keycube/k3pcb/matrice-pcb-keycube/image/Add-symbol-socket.png

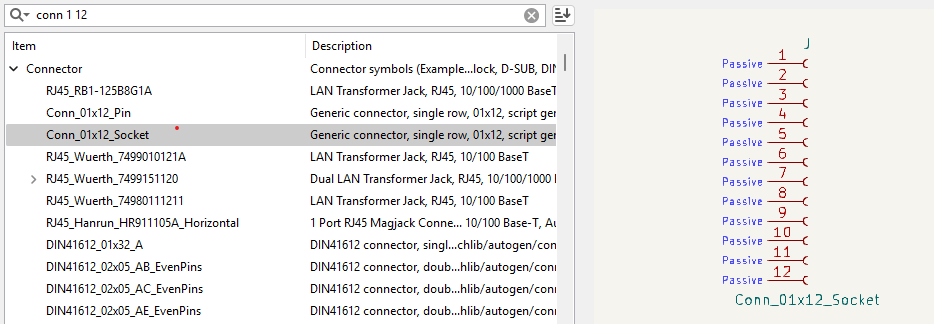
matrice-pcb-keycube/image/Add-symbol-socket.png
