keycube/k3pcb/shield-pcb-keycube/shield-keycube-v1/shield-keycube-v1.kicad_pcb

## KiCad design shield-pcb-keycube/shield-keycube-v1/shield-keycube-v1.kicad_pcb (2025-05-05)

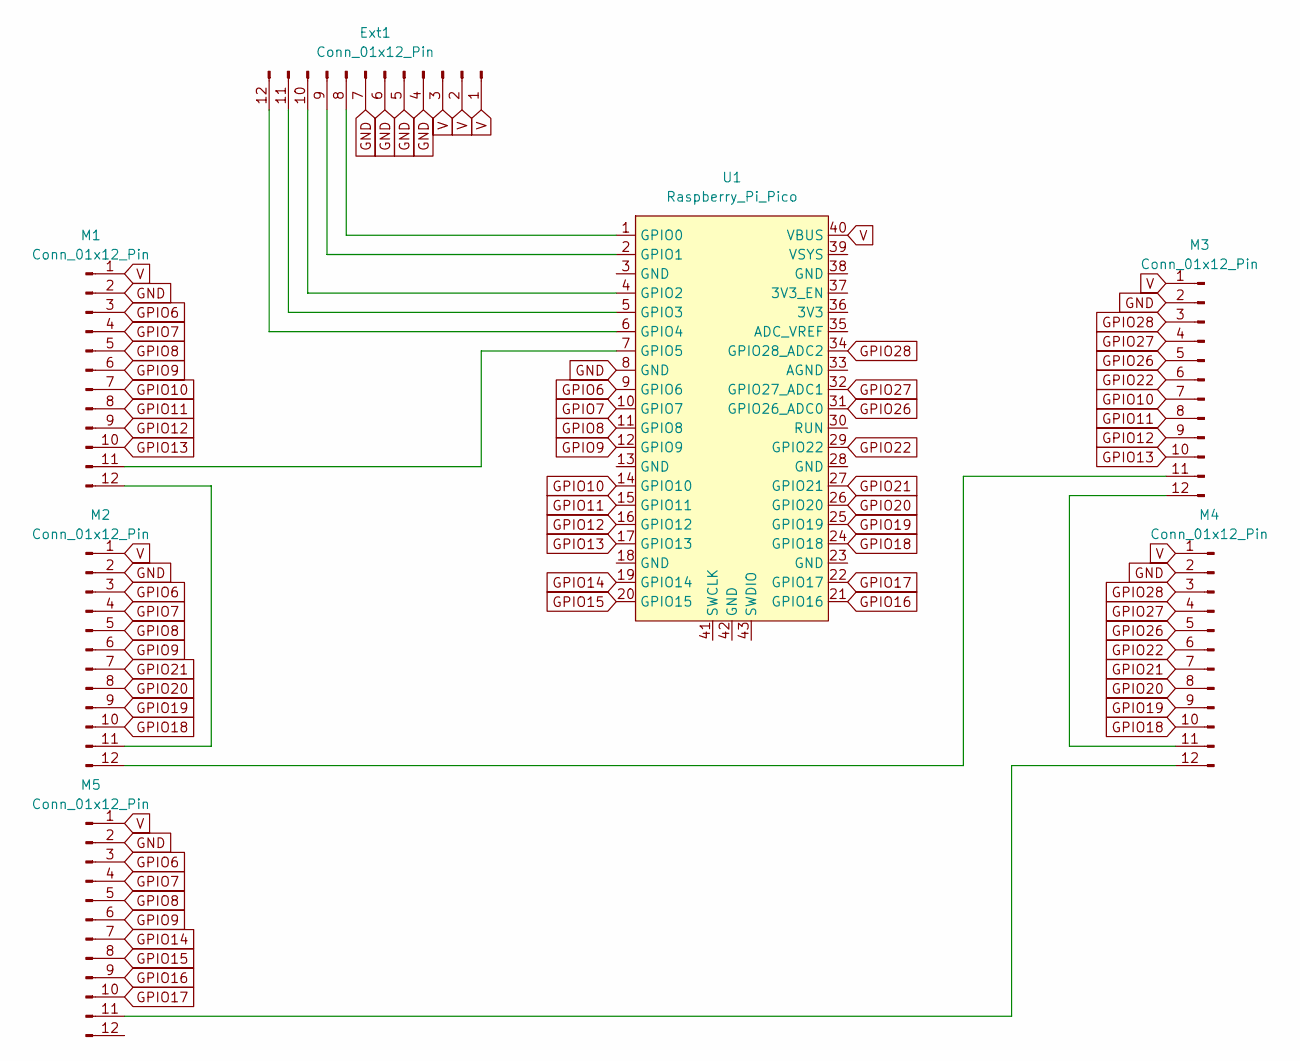
[picture p45: schematic shield-keycube-v1.kicad_sch]

Parts:
Ext1: Conn_01x12_Pin; PinHeader_1x12_P2.00mm_Vertical
M1, M2, M3, M4, M5: Conn_01x12_Pin; PinHeader_1x12_P2.00mm_Vertical
U1: Raspberry_Pi_Pico

Connections:
GND: Ext1.4, Ext1.5, Ext1.6, Ext1.7, M1.2, M2.2, M3.2, M4.2, M5.2, U1.8 (GND)
GPIO6: M1.3, M2.3, M5.3, U1.9 (GPIO6)
GPIO7: M1.4, M2.4, M5.4, U1.10 (GPIO7)
GPIO8: M1.5, M2.5, M5.5, U1.11 (GPIO8)
GPIO9: M1.6, M2.6, M5.6, U1.12 (GPIO9)
GPIO10: M1.7, M3.7, U1.14 (GPIO10)
GPIO11: M1.8, M3.8, U1.15 (GPIO11)
GPIO12: M1.9, M3.9, U1.16 (GPIO12)
GPIO13: M1.10, M3.10, U1.17 (GPIO13)
GPIO14: M5.7, U1.19 (GPIO14)
GPIO15: M5.8, U1.20 (GPIO15)
GPIO16: M5.9, U1.21 (GPIO16)
GPIO17: M5.10, U1.22 (GPIO17)
GPIO18: M2.10, M4.10, U1.24 (GPIO18)
GPIO19: M2.9, M4.9, U1.25 (GPIO19)
GPIO20: M2.8, M4.8, U1.26 (GPIO20)
GPIO21: M2.7, M4.7, U1.27 (GPIO21)
GPIO22: M3.6, M4.6, U1.29 (GPIO22)
GPIO26: M3.5, M4.5, U1.31 (GPIO26_ADC0)
GPIO27: M3.4, M4.4, U1.32 (GPIO27_ADC1)
GPIO28: M3.3, M4.3, U1.34 (GPIO28_ADC2)
unnamed: Ext1.8, U1.1 (GPIO0)
unnamed: Ext1.9, U1.2 (GPIO1)
unnamed: Ext1.10, U1.4 (GPIO2)
unnamed: Ext1.11, U1.5 (GPIO3)
unnamed: Ext1.12, U1.6 (GPIO4)
unnamed: M1.11, U1.7 (GPIO5)
unnamed: M1.12, M2.11
unnamed: M2.12, M3.11
unnamed: M3.12, M4.11
unnamed: M4.12, M5.11
V: Ext1.1, Ext1.2, Ext1.3, M1.1, M2.1, M3.1, M4.1, M5.1, U1.40 (VBUS)

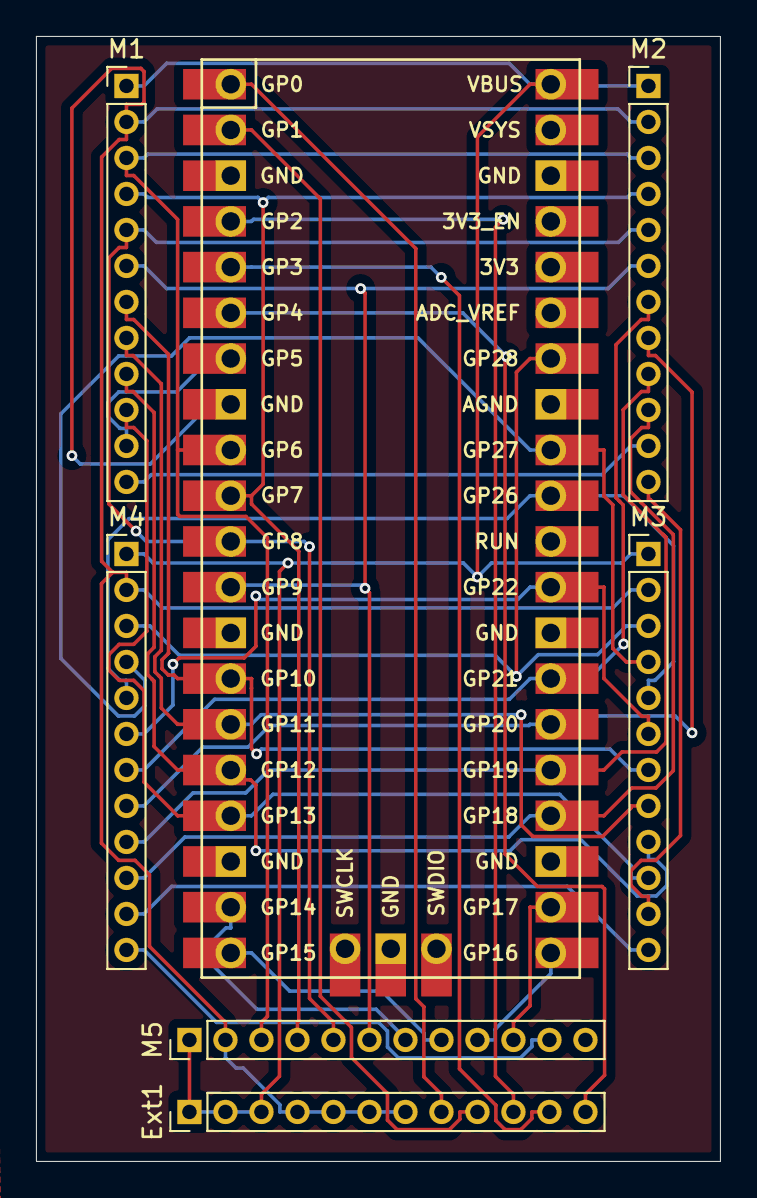
[picture p46: board shield-keycube-v1.kicad_pcb from above]

Board: 2 copper layers, 38.0 x 62.5 mm, 7 parts (0 on the bottom side), 32 nets.
