keycube/k3pcb/matrice-pcb-keycube/Matrix-keyboardV2.1(LED)/Matrix-keyboardV2.1(LED).kicad_pcb

## KiCad design matrice-pcb-keycube/Matrix-keyboardV2.1(LED)/Matrix-keyboardV2.1(LED).kicad_pcb (2025-04-30)

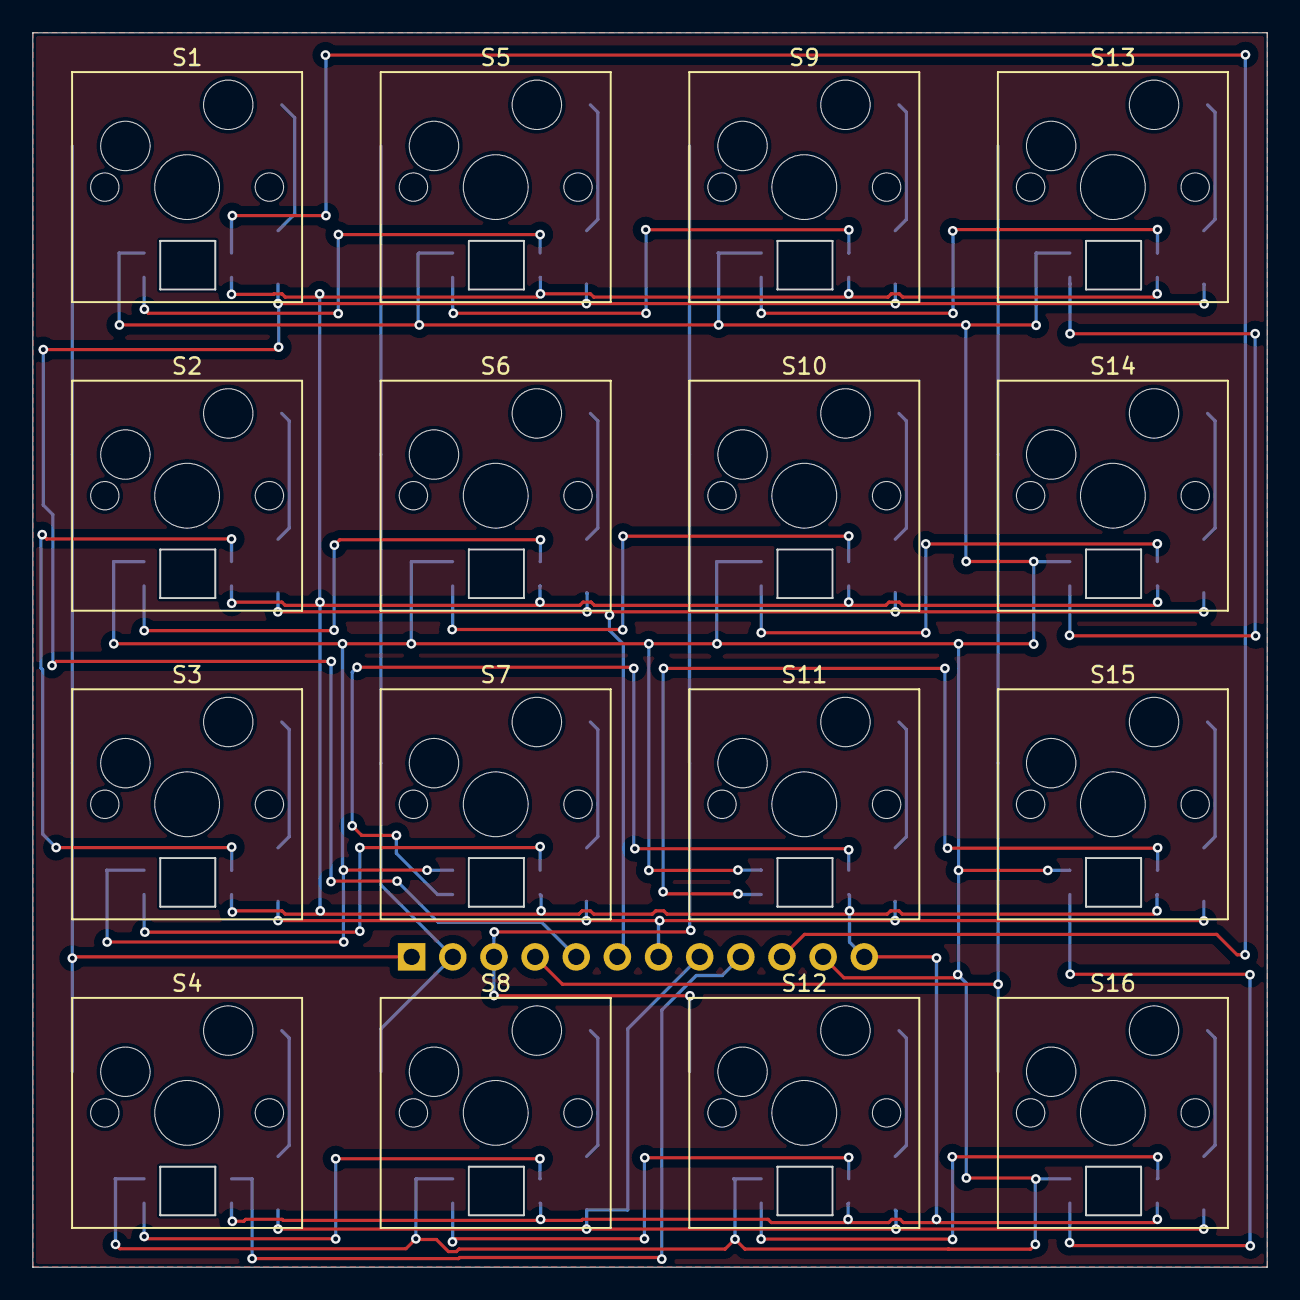
[picture p47: board Matrix-keyboardV2.1(LED).kicad_pcb from above]

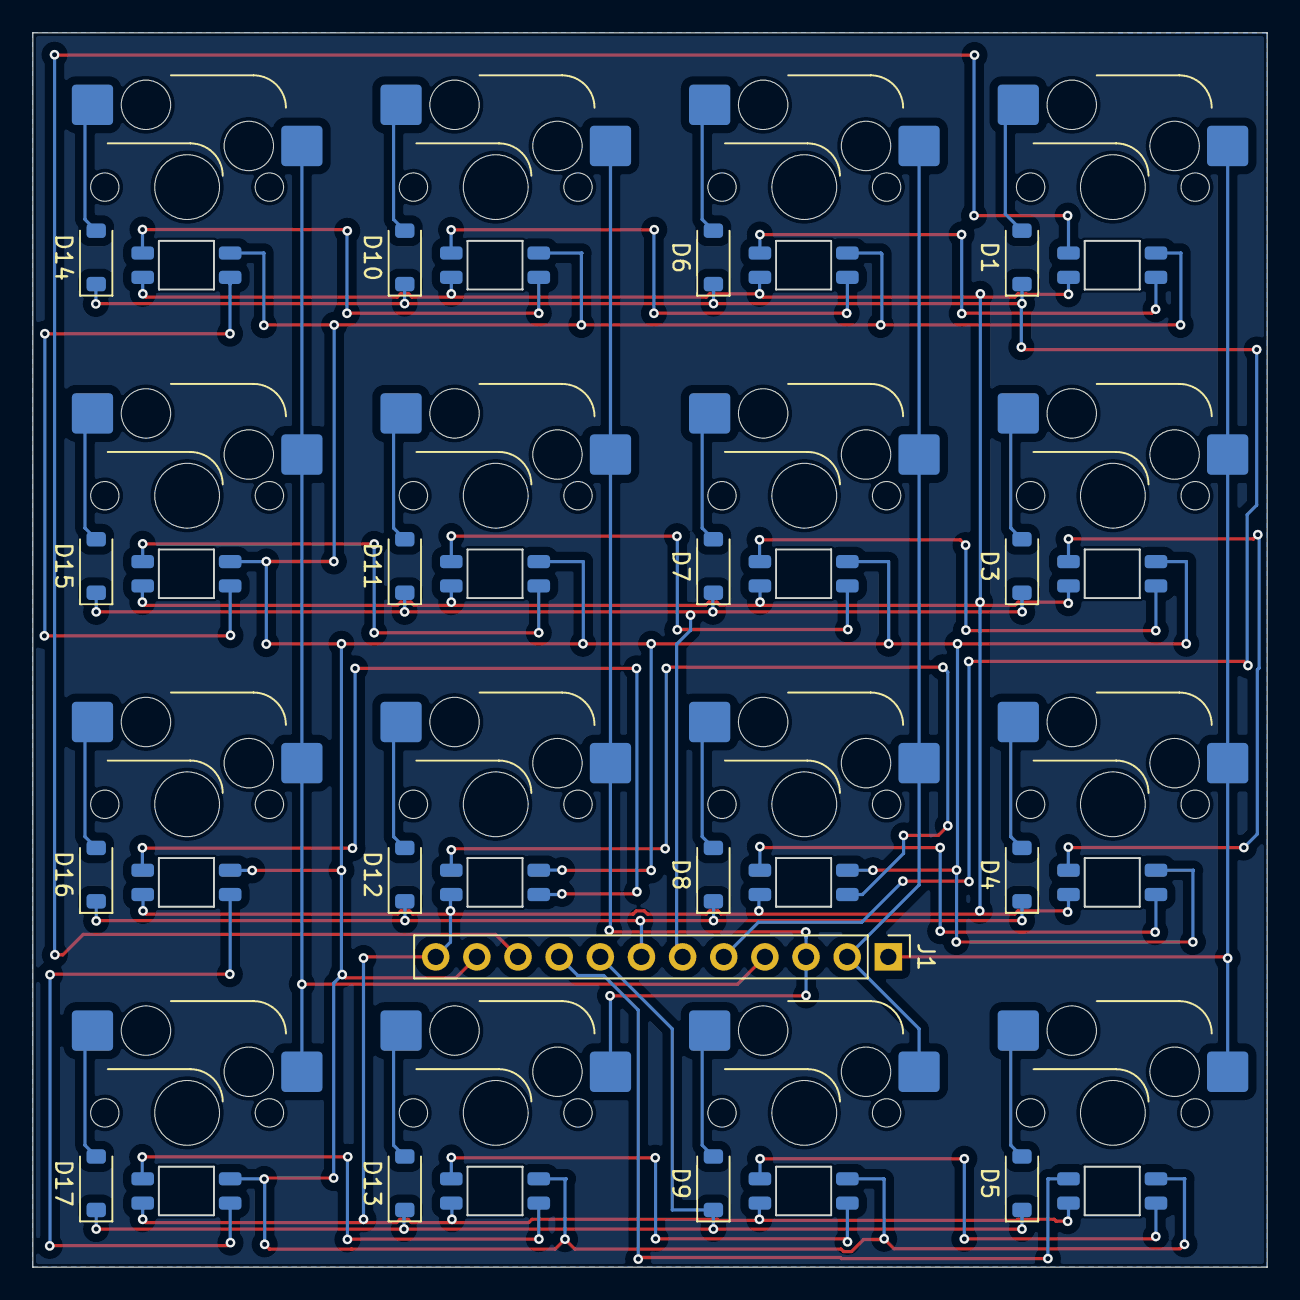
[picture p48: board Matrix-keyboardV2.1(LED).kicad_pcb from below]

Board: 2 copper layers, 76.2 x 76.2 mm, 49 parts (33 on the bottom side), 43 nets.

Parts:
D1, D3, D4, D5, D6, D7, D8, D9, D10, D11, D12, D13, D14, D15, D16, D17: 1N4148W; D_SOD-123
D2, D18, D19, D20, D21, D22, D23, D24, D25, D26, D27, D28, D29, D30, D31, D32: LED_SK6812MINI
J1: Conn_01x12_Socket; PinHeader_1x12_P2.54mm_Vertical
S1, S2, S3, S4, S5, S6, S7, S8, S9, S10, S11, S12, S13, S14, S15, S16: Keyswitch; Hotswap_MX_1.00u

Connections:
DIN: D2.4 (DIN), J1.10
DOUT: D26.4 (DIN), J1.9
unnamed: D1.2 (A), S1.2
unnamed: D3.2 (A), S2.2
unnamed: D4.2 (A), S3.2
unnamed: D5.2 (A), S4.2
unnamed: D6.2 (A), S5.2
unnamed: D7.2 (A), S6.2
unnamed: D8.2 (A), S7.2
unnamed: D9.2 (A), S8.2
unnamed: D10.2 (A), S9.2
unnamed: D11.2 (A), S10.2
unnamed: D12.2 (A), S11.2
unnamed: D13.2 (A), S12.2
unnamed: D14.2 (A), S13.2
unnamed: D15.2 (A), S14.2
unnamed: D16.2 (A), S15.2
unnamed: D17.2 (A), S16.2
unnamed: D2.2 (DOUT), D18.4 (DIN)
unnamed: D18.2 (DOUT), D19.4 (DIN)
unnamed: D19.2 (DOUT), D20.4 (DIN)
unnamed: D20.2 (DOUT), D24.2 (DOUT)
unnamed: D21.4 (DIN), D25.4 (DIN)
unnamed: D21.2 (DOUT), D22.4 (DIN)
unnamed: D22.2 (DOUT), D23.4 (DIN)
unnamed: D23.2 (DOUT), D24.4 (DIN)
unnamed: D25.2 (DOUT), D27.4 (DIN)
unnamed: D26.2 (DOUT), D28.4 (DIN)
unnamed: D27.2 (DOUT), D29.4 (DIN)
unnamed: D28.2 (DOUT), D30.4 (DIN)
unnamed: D29.2 (DOUT), D31.4 (DIN)
unnamed: D30.2 (DOUT), D32.4 (DIN)
unnamed: D31.2 (DOUT), D32.2 (DOUT)
VDD: D2.1 (VDD), D18.1 (VDD), D19.1 (VDD), D20.1 (VDD), D21.1 (VDD), D22.1 (VDD), D23.1 (VDD), D24.1 (VDD), D25.1 (VDD), D26.1 (VDD), D27.1 (VDD), D28.1 (VDD), D29.1 (VDD), D30.1 (VDD), D31.1 (VDD), D32.1 (VDD), J1.11
VSS: D2.3 (VSS), D18.3 (VSS), D19.3 (VSS), D20.3 (VSS), D21.3 (VSS), D22.3 (VSS), D23.3 (VSS), D24.3 (VSS), D25.3 (VSS), D26.3 (VSS), D27.3 (VSS), D28.3 (VSS), D29.3 (VSS), D30.3 (VSS), D31.3 (VSS), D32.3 (VSS), J1.12
column 1: J1.1, S1.1, S2.1, S3.1, S4.1
column 2: J1.2, S5.1, S6.1, S7.1, S8.1
column 3: J1.3, S9.1, S10.1, S11.1, S12.1
column 4: J1.4, S13.1, S14.1, S15.1, S16.1
row 1: D1.1 (K), D6.1 (K), D10.1 (K), D14.1 (K), J1.5
row 2: D3.1 (K), D7.1 (K), D11.1 (K), D15.1 (K), J1.6
row 3: D4.1 (K), D8.1 (K), D12.1 (K), D16.1 (K), J1.7
row 4: D5.1 (K), D9.1 (K), D13.1 (K), D17.1 (K), J1.8
