keycube/k3pcb/(commit log)

2025-04-30 ADD kicad project Matrice and his documentation
    [Matrix-keyboardV2.1(LED).kicad_pcb, Matrix-keyboardV2.1(LED).kicad_sch]
2025-05-05 Add shield kicad project. Fix missing line in doc.
    [shield-keycube-v1.kicad_pcb, shield-keycube-v1.kicad_sch]
